gianlucarenzi/abex-megaram/(list of files, drawings)

Other design files:
abex-megaram.dsn
