gianlucarenzi/abex-megaram/abex-megaram.kicad_pcb

## KiCad design abex-megaram.kicad_pcb (2019-07-20)

Schematic: abex-megaram.sch, ATARI XE 1 MegaRAM Expansion DEBUG/Logic

Parts:
C1: 100n; C_1206_HandSoldering
FT232RPi.1: CONN_01X03; Pin_Header_Straight_1x03
JP1: CONN_01X02; Pin_Header_Straight_1x02
JP2: CONN_01X04; Pin_Header_Angled_1x04
P1: 0877159106; BUS_PCIexpress_64pin
P2, P3, P4, P5: CONN_01X01; MountingHole
R1: 100K; R_1206_HandSoldering
R2: 0; R_1206_HandSoldering
SW1: SW_Push; SW_SPST_FSMSM_3D

Connections:
GND: C1.1, FT232RPi.1.1, JP1.2, JP2.1, P1.A1, P1.A5, P1.A9, P1.A13, P1.A17, P1.A21, P1.A25, P1.A29, P1.A32, P1.B17, P1.B21, P1.B25, R2.2, SW1.1; also elsewhere on the board
SWDCLK: JP2.3, P1.B29; also elsewhere on the board
SWDIO: JP2.2, P1.B27; also elsewhere on the board
SWDRST: C1.2, JP1.1, P1.B31, R1.1, SW1.2; also elsewhere on the board
UART_RX: FT232RPi.1.2; also elsewhere on the board
UART_TX: FT232RPi.1.3; also elsewhere on the board
VCC_3V3: JP2.4, P1.A3, P1.A7, P1.A11, P1.A15, P1.A19, P1.A23, P1.A27, P1.B19, P1.B23, R1.2; also elsewhere on the board
mA0: P1.B32; also elsewhere on the board
mA1: P1.B30; also elsewhere on the board
mA2: P1.B28; also elsewhere on the board
mA3: P1.B26; also elsewhere on the board
mA4: P1.B24; also elsewhere on the board
mA5: P1.B22; also elsewhere on the board
mA6: P1.B20; also elsewhere on the board
mA7: P1.B18; also elsewhere on the board
mA8: P1.B16; also elsewhere on the board
mA9: P1.B14; also elsewhere on the board
mA10: P1.B12; also elsewhere on the board
mA11: P1.B10; also elsewhere on the board
mA12: P1.B8; also elsewhere on the board
mA13: P1.B6; also elsewhere on the board
mA14: P1.B4; also elsewhere on the board
mA15: P1.B2; also elsewhere on the board
mAUDIO: P1.A6, R2.1
mD0: P1.B15; also elsewhere on the board
mD1: P1.B13; also elsewhere on the board
mD2: P1.B11; also elsewhere on the board
mD3: P1.B9; also elsewhere on the board
mD4: P1.B7; also elsewhere on the board
mD5: P1.B5; also elsewhere on the board
mD6: P1.B3; also elsewhere on the board
mD7: P1.B1; also elsewhere on the board
mPHI2: P1.A4; also elsewhere on the board
mR/~W: P1.A10; also elsewhere on the board
mRD4: P1.A24; also elsewhere on the board
mRD5: P1.A28; also elsewhere on the board
~mCCTL: P1.A30; also elsewhere on the board
~mD1XX: P1.A18; also elsewhere on the board
~mEXSEL: P1.A12; also elsewhere on the board
~mHALT: P1.A16; also elsewhere on the board
~mIRQ: P1.A14; also elsewhere on the board
~mMPD: P1.A20; also elsewhere on the board
~mREF: P1.A8; also elsewhere on the board
~mRST: P1.A2; also elsewhere on the board
~mS4: P1.A22; also elsewhere on the board
~mS5: P1.A26; also elsewhere on the board

Notes on the sheet:
DEBUG/PROGRAMMING SECTION MEMORY
MOUNTING HOLES
RESET BUTTON MEM
EXTENDED BUS PINS ARE CONNECTED IN THE SLOT BUT LEFT UNTRACKED
DNP
ABEX PCI EXPRESS CARD CONNECTOR 64 PIN
A31 is +5VDC. We do not need here

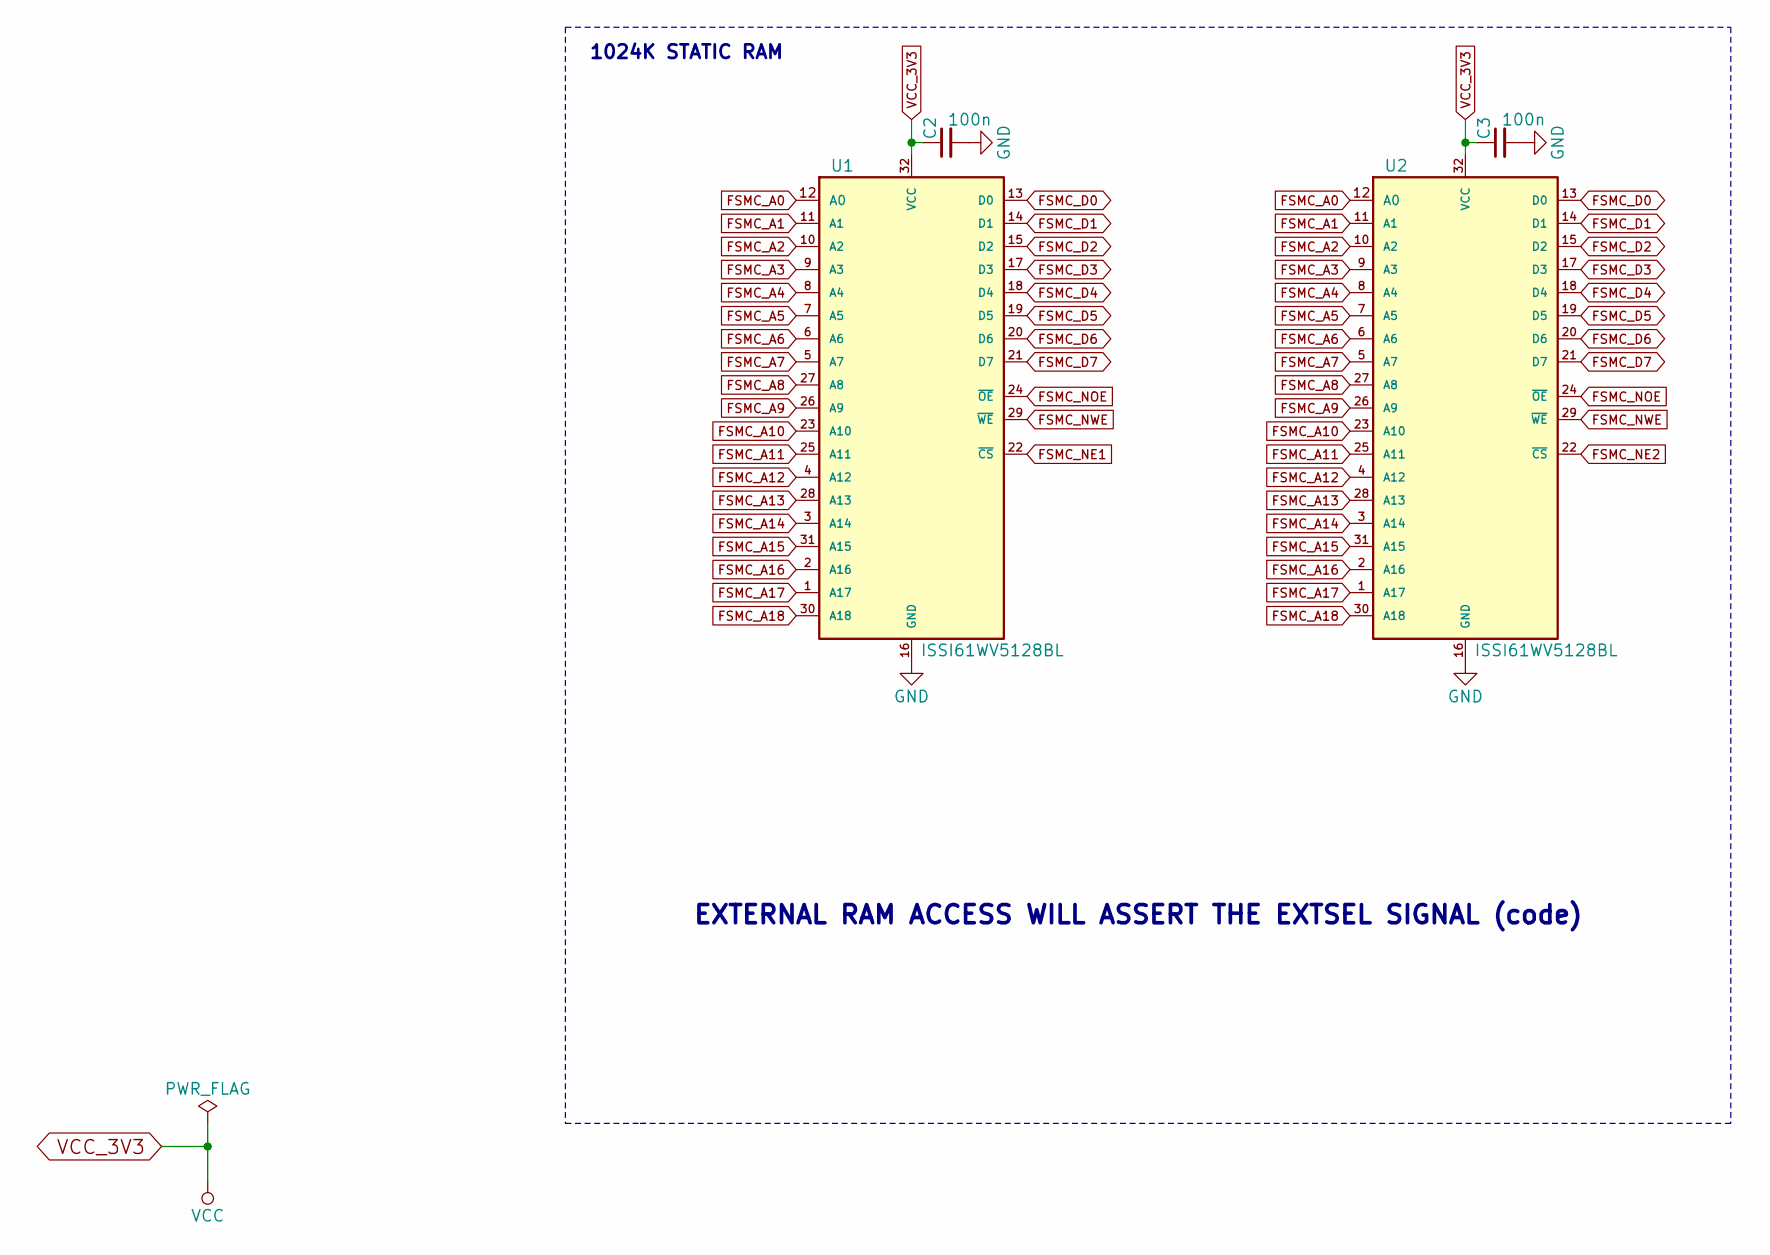
[picture p7: schematic sram-levelshifters.sch, STATIC RAM 1 MByte (512K x 8 x 2)]

Parts:
C2, C3: 100n; C_1206_HandSoldering
U1, U2: ISSI61WV5128BL; SOP-32L-20.5x11.30-1.27mm

Connections:
FSMC_A0: U1.12 (A0), U2.12 (A0); also elsewhere on the board
FSMC_A1: U1.11 (A1), U2.11 (A1); also elsewhere on the board
FSMC_A2: U1.10 (A2), U2.10 (A2); also elsewhere on the board
FSMC_A3: U1.9 (A3), U2.9 (A3); also elsewhere on the board
FSMC_A4: U1.8 (A4), U2.8 (A4); also elsewhere on the board
FSMC_A5: U1.7 (A5), U2.7 (A5); also elsewhere on the board
FSMC_A6: U1.6 (A6), U2.6 (A6); also elsewhere on the board
FSMC_A7: U1.5 (A7), U2.5 (A7); also elsewhere on the board
FSMC_A8: U1.27 (A8), U2.27 (A8); also elsewhere on the board
FSMC_A9: U1.26 (A9), U2.26 (A9); also elsewhere on the board
FSMC_A10: U1.23 (A10), U2.23 (A10); also elsewhere on the board
FSMC_A11: U1.25 (A11), U2.25 (A11); also elsewhere on the board
FSMC_A12: U1.4 (A12), U2.4 (A12); also elsewhere on the board
FSMC_A13: U1.28 (A13), U2.28 (A13); also elsewhere on the board
FSMC_A14: U1.3 (A14), U2.3 (A14); also elsewhere on the board
FSMC_A15: U1.31 (A15), U2.31 (A15); also elsewhere on the board
FSMC_A16: U1.2 (A16), U2.2 (A16); also elsewhere on the board
FSMC_A17: U1.1 (A17), U2.1 (A17); also elsewhere on the board
FSMC_A18: U1.30 (A18), U2.30 (A18); also elsewhere on the board
FSMC_D0: U1.13 (D0), U2.13 (D0); also elsewhere on the board
FSMC_D1: U1.14 (D1), U2.14 (D1); also elsewhere on the board
FSMC_D2: U1.15 (D2), U2.15 (D2); also elsewhere on the board
FSMC_D3: U1.17 (D3), U2.17 (D3); also elsewhere on the board
FSMC_D4: U1.18 (D4), U2.18 (D4); also elsewhere on the board
FSMC_D5: U1.19 (D5), U2.19 (D5); also elsewhere on the board
FSMC_D6: U1.20 (D6), U2.20 (D6); also elsewhere on the board
FSMC_D7: U1.21 (D7), U2.21 (D7); also elsewhere on the board
FSMC_NE1: U1.22 (~CS); also elsewhere on the board
FSMC_NE2: U2.22 (~CS); also elsewhere on the board
FSMC_NOE: U1.24 (~OE), U2.24 (~OE); also elsewhere on the board
FSMC_NWE: U1.29 (~WE), U2.29 (~WE); also elsewhere on the board
GND: C2.2, C3.2, U1.16 (GND), U2.16 (GND); also elsewhere on the board
VCC_3V3: C2.1, C3.1, U1.32 (VCC), U2.32 (VCC); also elsewhere on the board

Notes on the sheet:
1024K STATIC RAM
EXTERNAL RAM ACCESS WILL ASSERT THE EXTSEL SIGNAL (code)

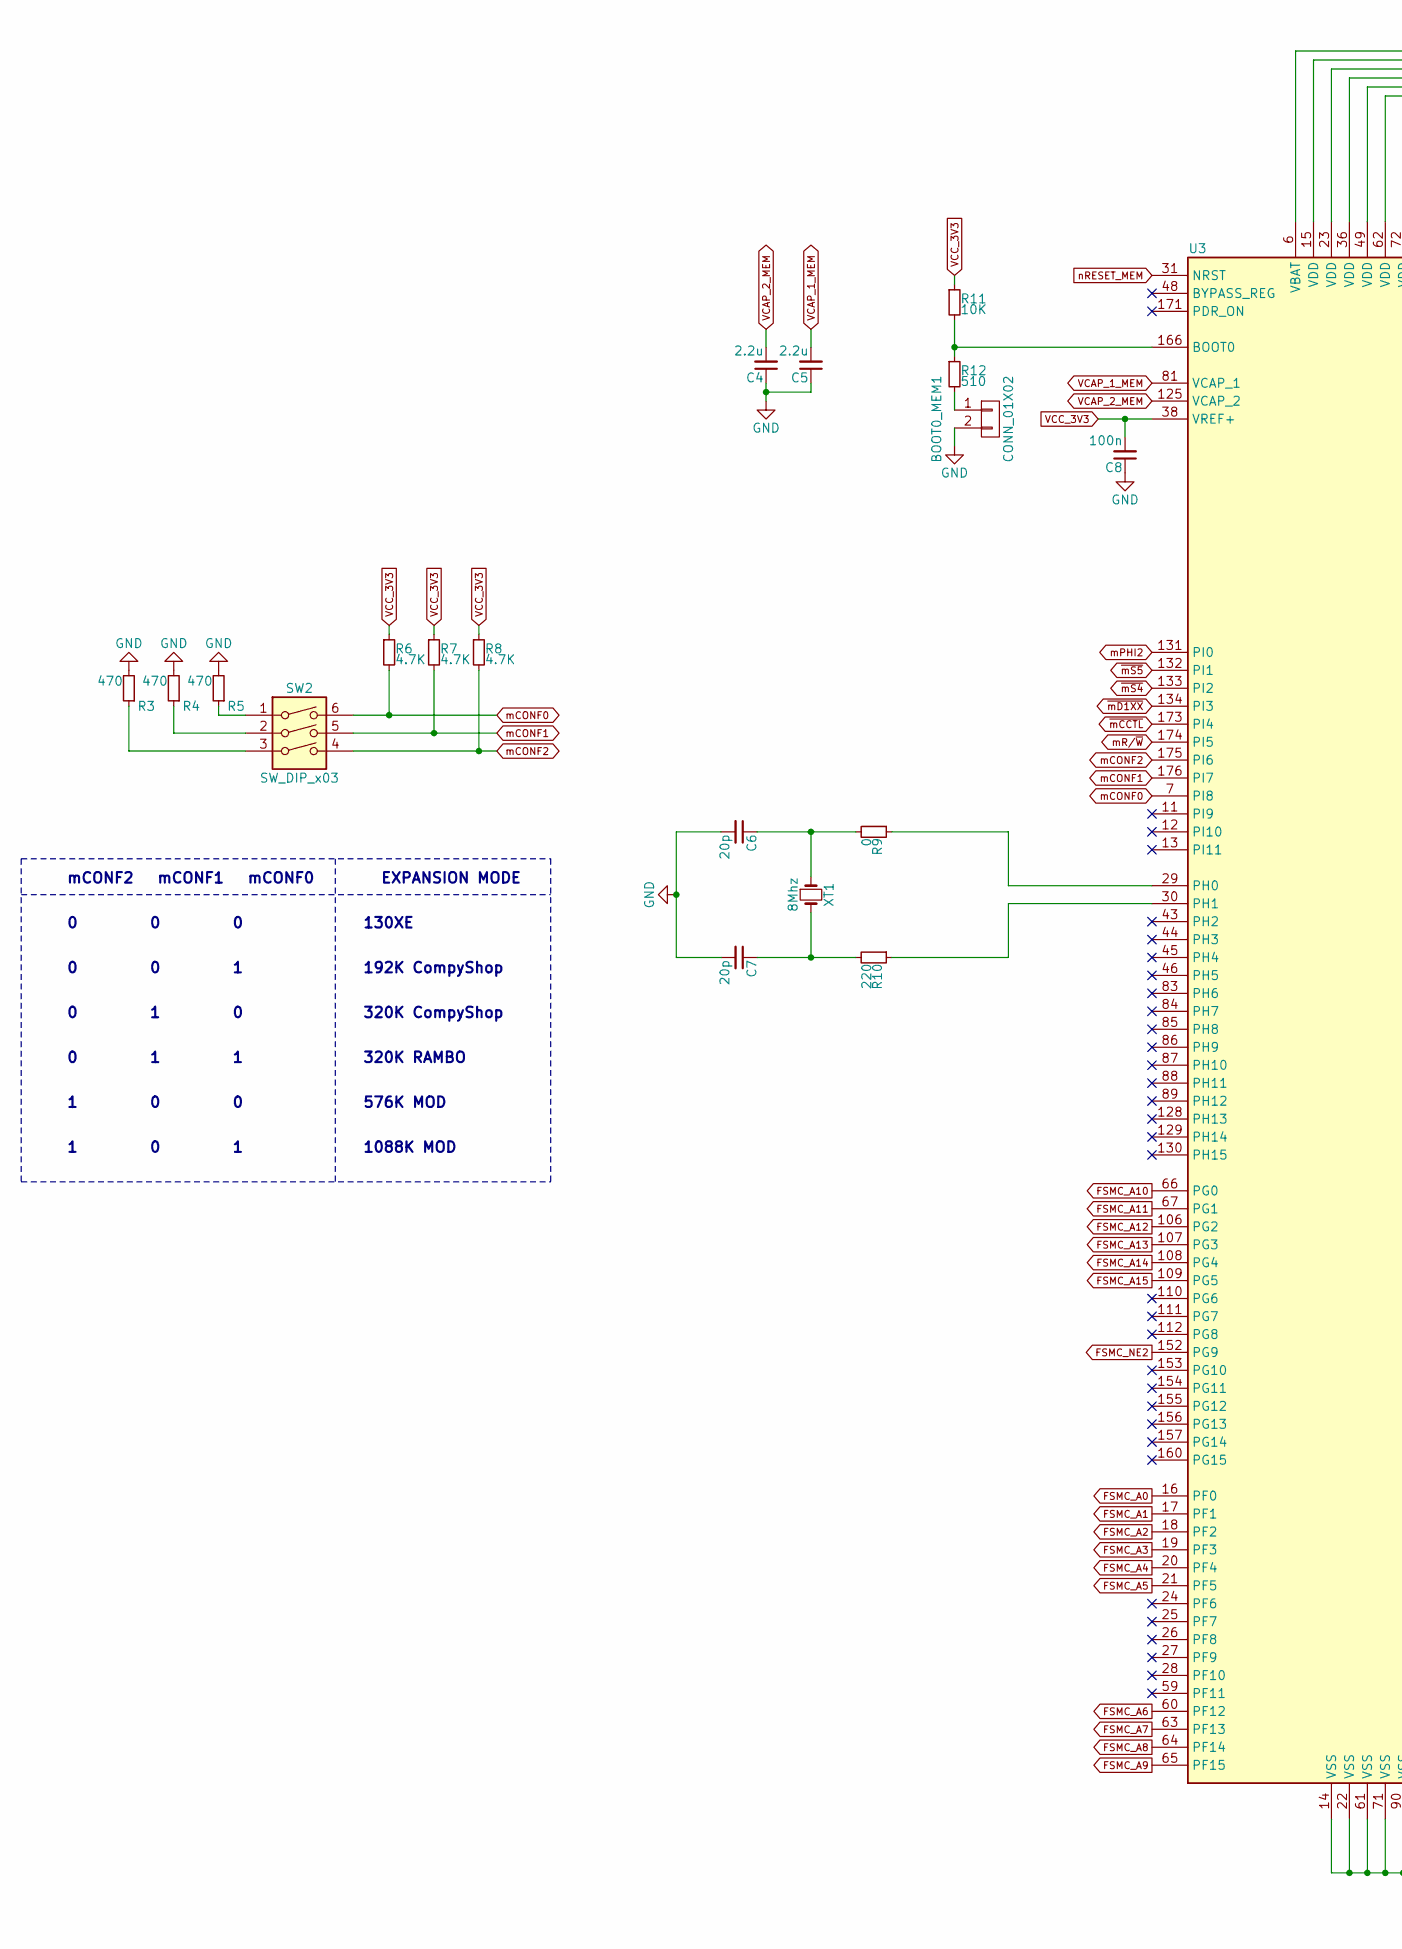
[picture p8: schematic memory_controller.sch, MCU STM32F407VET6 MEMORY CONTROLLER, part in row 1, column 1]

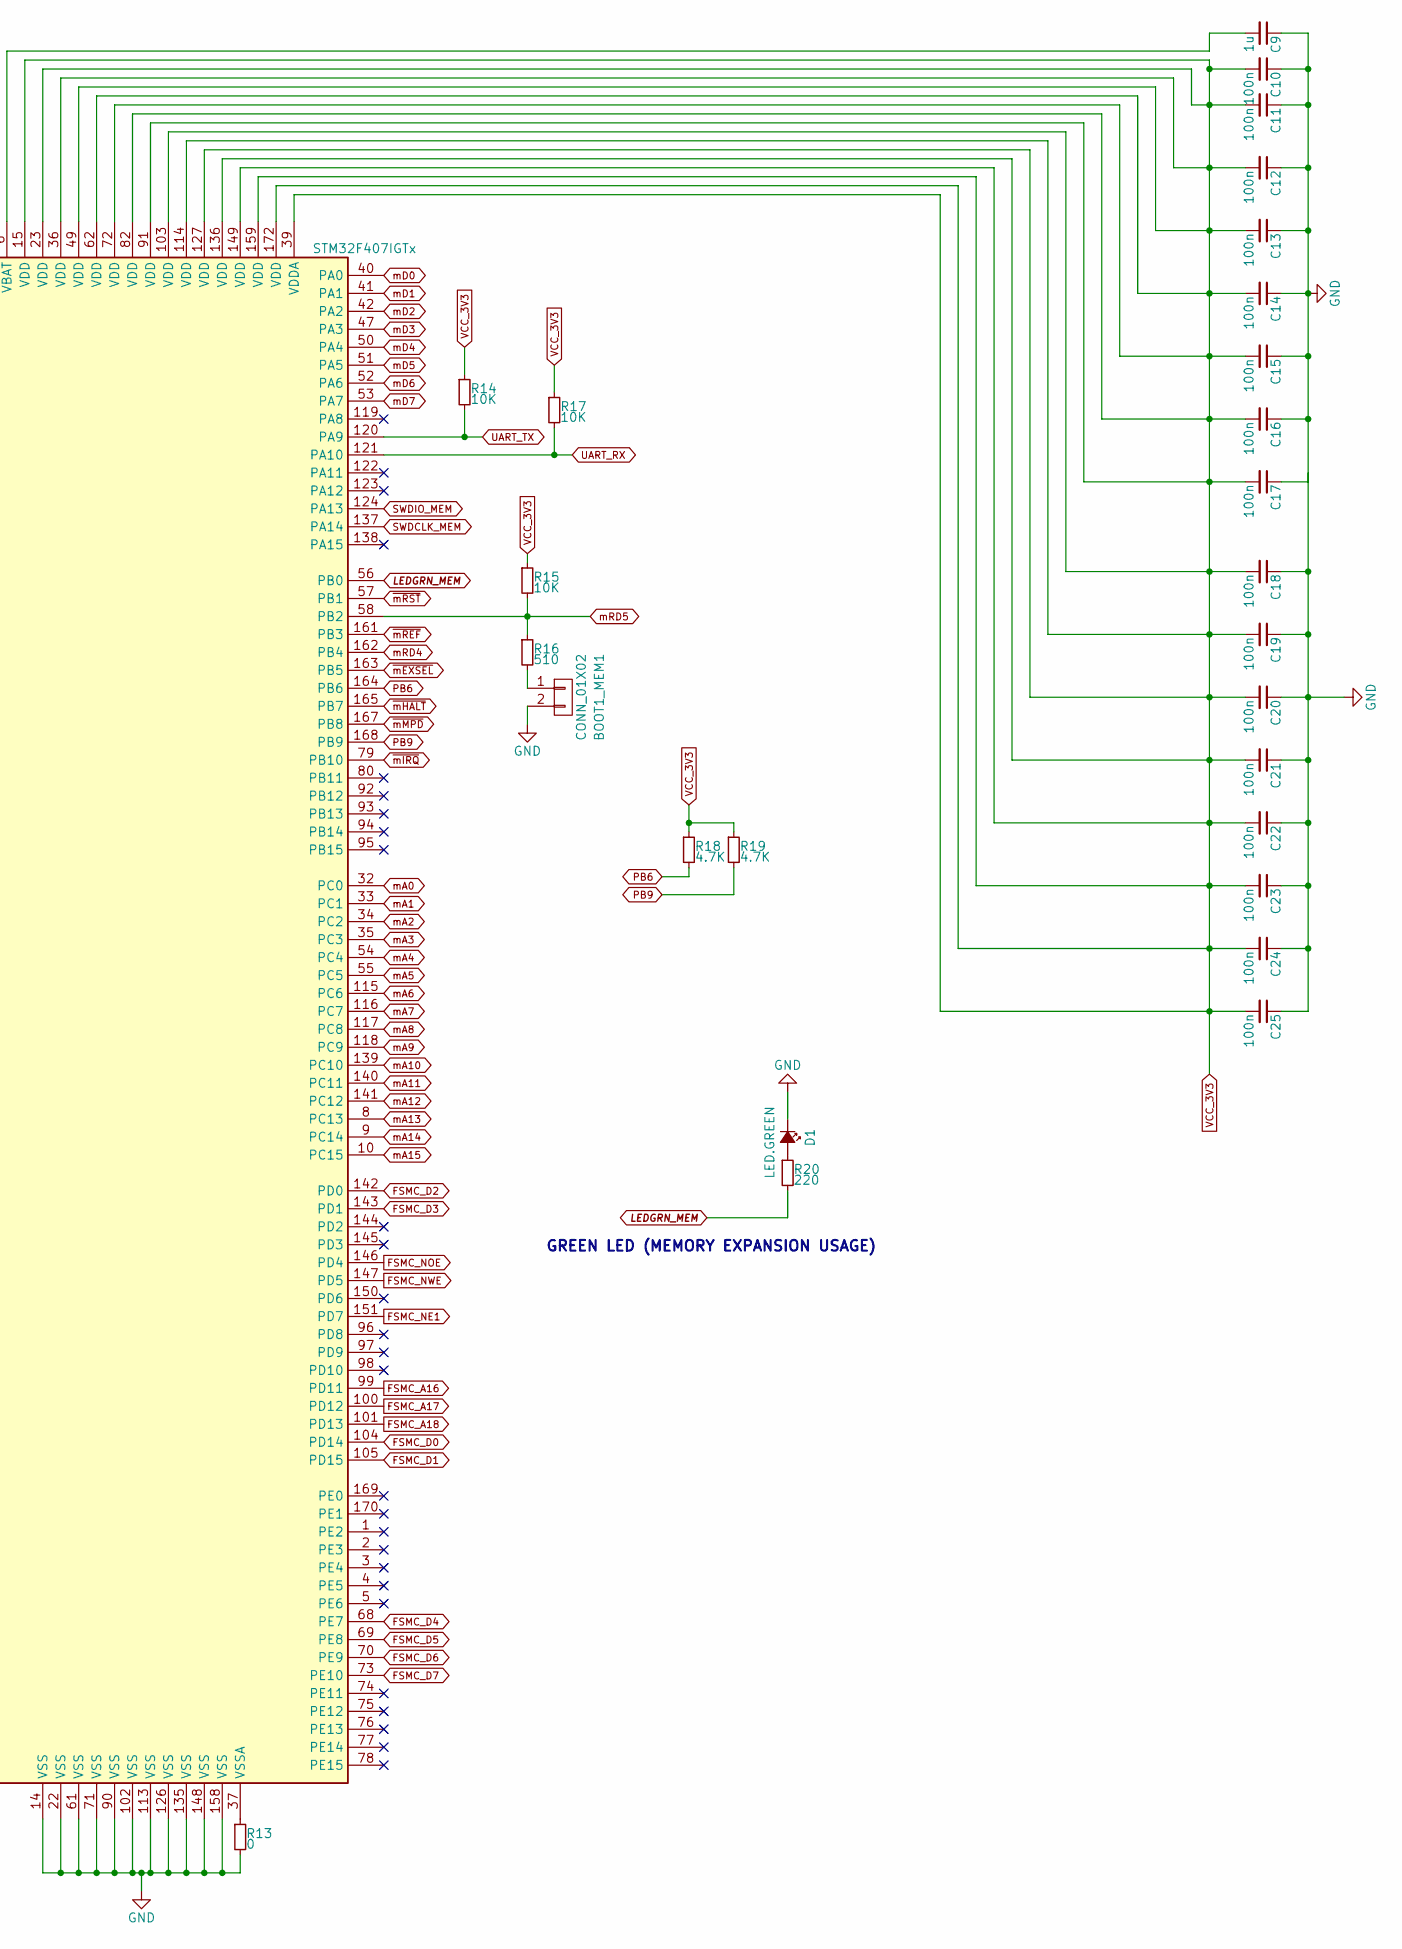
[picture p9: schematic memory_controller.sch, MCU STM32F407VET6 MEMORY CONTROLLER, part in row 1, column 2]

Parts:
BOOT0_MEM1, BOOT1_MEM1: CONN_01X02; Pin_Header_Straight_1x02
C4, C5: 2.2u; C_1206_HandSoldering
C6, C7: 20p; C_1206_HandSoldering
C8, C10, C11, C12, C13, C14, C15, C16, C17, C18, C19, C20, C21, C22, C23, C24, C25: 100n; C_1206_HandSoldering
C9: 1u; C_1206_HandSoldering
D1: LED.GREEN; LED_1206
R3, R4, R5: 470; R_1206_HandSoldering
R6, R7, R8, R18, R19: 4.7K; R_1206_HandSoldering
R9, R13: 0; R_1206_HandSoldering
R10, R20: 220; R_1206_HandSoldering
R11, R14, R15, R17: 10K; R_1206_HandSoldering
R12, R16: 510; R_1206_HandSoldering
SW2: SW_DIP_x03; SW_DIP_SPSTx03_Slide_9.78x9.8mm_W8.61mm_P2.54mm
U3: STM32F407IGTx; LQFP-176_24x24mm_Pitch0.5mm
XT1: 8Mhz; Crystal_HC49-4H_Vertical_3D

Connections:
FSMC_A0: U3.16 (PF0); also elsewhere on the board
FSMC_A1: U3.17 (PF1); also elsewhere on the board
FSMC_A2: U3.18 (PF2); also elsewhere on the board
FSMC_A3: U3.19 (PF3); also elsewhere on the board
FSMC_A4: U3.20 (PF4); also elsewhere on the board
FSMC_A5: U3.21 (PF5); also elsewhere on the board
FSMC_A6: U3.60 (PF12); also elsewhere on the board
FSMC_A7: U3.63 (PF13); also elsewhere on the board
FSMC_A8: U3.64 (PF14); also elsewhere on the board
FSMC_A9: U3.65 (PF15); also elsewhere on the board
FSMC_A10: U3.66 (PG0); also elsewhere on the board
FSMC_A11: U3.67 (PG1); also elsewhere on the board
FSMC_A12: U3.106 (PG2); also elsewhere on the board
FSMC_A13: U3.107 (PG3); also elsewhere on the board
FSMC_A14: U3.108 (PG4); also elsewhere on the board
FSMC_A15: U3.109 (PG5); also elsewhere on the board
FSMC_A16: U3.99 (PD11); also elsewhere on the board
FSMC_A17: U3.100 (PD12); also elsewhere on the board
FSMC_A18: U3.101 (PD13); also elsewhere on the board
FSMC_D0: U3.104 (PD14); also elsewhere on the board
FSMC_D1: U3.105 (PD15); also elsewhere on the board
FSMC_D2: U3.142 (PD0); also elsewhere on the board
FSMC_D3: U3.143 (PD1); also elsewhere on the board
FSMC_D4: U3.68 (PE7); also elsewhere on the board
FSMC_D5: U3.69 (PE8); also elsewhere on the board
FSMC_D6: U3.70 (PE9); also elsewhere on the board
FSMC_D7: U3.73 (PE10); also elsewhere on the board
FSMC_NE1: U3.151 (PD7); also elsewhere on the board
FSMC_NE2: U3.152 (PG9); also elsewhere on the board
FSMC_NOE: U3.146 (PD4); also elsewhere on the board
FSMC_NWE: U3.147 (PD5); also elsewhere on the board
GND: BOOT0_MEM1.2, BOOT1_MEM1.2, C4.1, C5.1, C6.2, C7.2, C8.1, C9.1, C10.1, C11.1, C12.1, C13.1, C14.1, C15.1, C16.1, C17.1, C18.1, C19.1, C20.1, C21.1, C22.1, C23.1, C24.1, C25.1, D1.1 (K), R3.2, R4.2, R5.2, R13.2, U3.14 (VSS), U3.22 (VSS), U3.61 (VSS), U3.71 (VSS), U3.90 (VSS), U3.102 (VSS), U3.113 (VSS), U3.126 (VSS), U3.135 (VSS), U3.148 (VSS), U3.158 (VSS); also elsewhere on the board
LEDGRN_MEM: R20.2, U3.56 (PB0)
unnamed: BOOT0_MEM1.1, R12.2
unnamed: BOOT1_MEM1.1, R16.2
unnamed: C6.1, R9.2, XT1.1
unnamed: C7.1, R10.2, XT1.2
unnamed: C9.2, U3.6 (VBAT)
unnamed: D1.2 (A), R20.1
unnamed: R3.1, SW2.3
unnamed: R4.1, SW2.2
unnamed: R5.1, SW2.1
unnamed: R9.1, U3.29 (PH0)
unnamed: R10.1, U3.30 (PH1)
unnamed: R11.2, R12.1, U3.166 (BOOT0)
unnamed: R13.1, U3.37 (VSSA)
PB6: R18.2, U3.164 (PB6)
PB9: R19.2, U3.168 (PB9)
SWDCLK: U3.137 (PA14); also elsewhere on the board
SWDIO: U3.124 (PA13); also elsewhere on the board
SWDRST: U3.31 (NRST); also elsewhere on the board
UART_RX: R17.2, U3.121 (PA10); also elsewhere on the board
UART_TX: R14.2, U3.120 (PA9); also elsewhere on the board
VCAP_1_MEM: C5.2, U3.81 (VCAP_1)
VCAP_2_MEM: C4.2, U3.125 (VCAP_2)
VCC_3V3: C8.2, C10.2, C11.2, C12.2, C13.2, C14.2, C15.2, C16.2, C17.2, C18.2, C19.2, C20.2, C21.2, C22.2, C23.2, C24.2, C25.2, R6.1, R7.1, R8.1, R11.1, R14.1, R15.1, R17.1, R18.1, R19.1, U3.15 (VDD), U3.23 (VDD), U3.36 (VDD), U3.38 (VREF+), U3.39 (VDDA), U3.49 (VDD), U3.62 (VDD), U3.72 (VDD), U3.82 (VDD), U3.91 (VDD), U3.103 (VDD), U3.114 (VDD), U3.127 (VDD), U3.136 (VDD), U3.149 (VDD), U3.159 (VDD), U3.172 (VDD); also elsewhere on the board
mA0: U3.32 (PC0); also elsewhere on the board
mA1: U3.33 (PC1); also elsewhere on the board
mA2: U3.34 (PC2); also elsewhere on the board
mA3: U3.35 (PC3); also elsewhere on the board
mA4: U3.54 (PC4); also elsewhere on the board
mA5: U3.55 (PC5); also elsewhere on the board
mA6: U3.115 (PC6); also elsewhere on the board
mA7: U3.116 (PC7); also elsewhere on the board
mA8: U3.117 (PC8); also elsewhere on the board
mA9: U3.118 (PC9); also elsewhere on the board
mA10: U3.139 (PC10); also elsewhere on the board
mA11: U3.140 (PC11); also elsewhere on the board
mA12: U3.141 (PC12); also elsewhere on the board
mA13: U3.8 (PC13); also elsewhere on the board
mA14: U3.9 (PC14); also elsewhere on the board
mA15: U3.10 (PC15); also elsewhere on the board
mCONF0: R6.2, SW2.6, U3.7 (PI8)
mCONF1: R7.2, SW2.5, U3.176 (PI7)
mCONF2: R8.2, SW2.4, U3.175 (PI6)
mD0: U3.40 (PA0); also elsewhere on the board
mD1: U3.41 (PA1); also elsewhere on the board
mD2: U3.42 (PA2); also elsewhere on the board
mD3: U3.47 (PA3); also elsewhere on the board
mD4: U3.50 (PA4); also elsewhere on the board
mD5: U3.51 (PA5); also elsewhere on the board
mD6: U3.52 (PA6); also elsewhere on the board
mD7: U3.53 (PA7); also elsewhere on the board
mPHI2: U3.131 (PI0); also elsewhere on the board
mR/~W: U3.174 (PI5); also elsewhere on the board
mRD4: U3.162 (PB4); also elsewhere on the board
mRD5: R15.2, R16.1, U3.58 (PB2); also elsewhere on the board
~mCCTL: U3.173 (PI4); also elsewhere on the board
~mD1XX: U3.134 (PI3); also elsewhere on the board
~mEXSEL: U3.163 (PB5); also elsewhere on the board
~mHALT: U3.165 (PB7); also elsewhere on the board
~mIRQ: U3.79 (PB10); also elsewhere on the board
~mMPD: U3.167 (PB8); also elsewhere on the board
~mREF: U3.161 (PB3); also elsewhere on the board
~mRST: U3.57 (PB1); also elsewhere on the board
~mS4: U3.133 (PI2); also elsewhere on the board
~mS5: U3.132 (PI1); also elsewhere on the board

Notes on the sheet:
GREEN LED (MEMORY EXPANSION USAGE)
mCONF2 mCONF1 mCONF0
0 0 0
0 0 1
0 1 0
0 1 1
1 0 1
130XE
192K CompyShop
320K CompyShop
320K RAMBO
1088K MOD
EXPANSION MODE
1 0 0
576K MOD

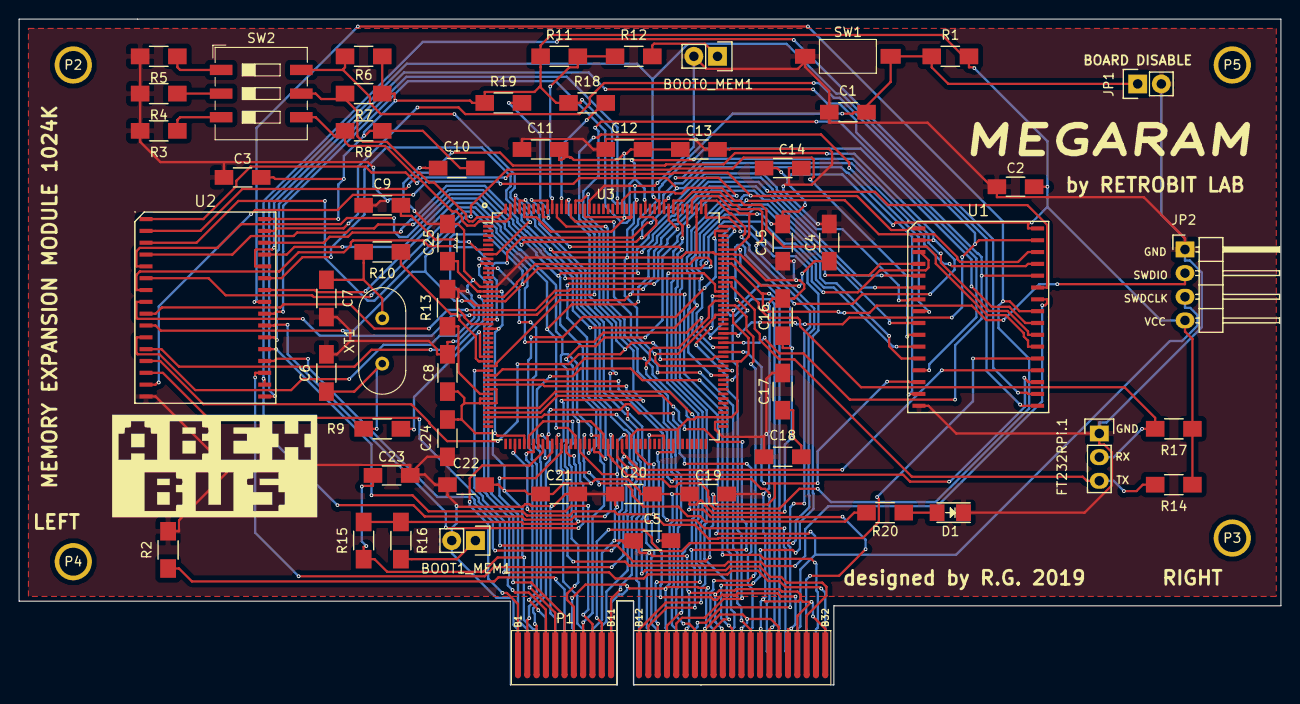
[picture p10: board abex-megaram.kicad_pcb from above]

Board: 2 copper layers, 135.5 x 71.5 mm, 62 parts (0 on the bottom side), 98 nets.
