gianlucarenzi/abex-megaram/(commit log)

2019-05-25 Frist Commit
    [abex-megaram-B.Cu.gbl, abex-megaram-B.Mask.gbs, abex-megaram-B.Paste.gbp, abex-megaram-B.SilkS.gbo, abex-megaram-Edge.Cuts.gm1, abex-megaram-F.Cu.gtl, abex-megaram-F.Mask.gts, abex-megaram-F.Paste.gtp]
2019-06-02 Added a three channel dip-switch for select configuration
    [abex-megaram-B.Cu.gbl, abex-megaram-B.Mask.gbs, abex-megaram-B.Paste.gbp, abex-megaram-B.SilkS.gbo, abex-megaram-Edge.Cuts.gm1, abex-megaram-F.Cu.gtl, abex-megaram-F.Mask.gts, abex-megaram-F.Paste.gtp]
2019-06-04 Aggiunto .gitignore per il risultato di compilazione
2019-06-27 Added for STM32 flash programming via OpenOCD
    [stm32f4eval.cfg]
2019-06-27 Added configuration pin (dip-switches) The data bus is now connected to the lower bits of the portE, so no need for shifting when read/write to the ATARI MCU DataBus. It will improve the efficiency
2019-06-27 Optimized for 8 bit access. Added a configuration option. A31 on connector is 5VDC. Not used here
    [abex-megaram-B.Cu.gbl, abex-megaram-B.Mask.gbs, abex-megaram-B.Paste.gbp, abex-megaram-B.SilkS.gbo, abex-megaram-Edge.Cuts.gm1, abex-megaram-F.Cu.gtl, abex-megaram-F.Mask.gts, abex-megaram-F.Paste.gtp]
2019-07-19 Upgraded to a dual chip select for external SRAM. In this case up to 1536k can be addressable
    [abex-megaram-B.Cu.gbl, abex-megaram-B.Mask.gbs, abex-megaram-B.Paste.gbp, abex-megaram-B.SilkS.gbo, abex-megaram-Edge.Cuts.gm1, abex-megaram-F.Cu.gtl, abex-megaram-F.Mask.gts, abex-megaram-F.Paste.gtp]
2019-07-19 Added nOE and nWE from the GPIOs
    [abex-megaram.dsn, abex-megaram.kicad_pcb, memory_controller.sch, sram-levelshifters.sch]
2019-07-20 New layout and design
    [abex-megaram-B.Cu.gbl, abex-megaram-B.Mask.gbs, abex-megaram-B.Paste.gbp, abex-megaram-B.SilkS.gbo, abex-megaram-Edge.Cuts.gm1, abex-megaram-F.Cu.gtl, abex-megaram-F.Mask.gts, abex-megaram-F.Paste.gtp]
2019-07-24 Corrected comment. Added the control of the PBCTL & (1 << 2) to write internally to PORTB as asked by Warerat of AtariAge's Forum
    [main.c]
2019-07-25 Added for SoC Programming and Controlling
    [stm32f4eval.cfg]
2019-07-25 - Heavily modified as the control bit as atari800 emulator and the RAMBO 256K Expansion Reference Manual - Added the possibility to program the compatibility mode from atari. Simply write 255 times t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
    [main.c]
2019-07-26 Added printf support
2025-11-01 RetroBitLab library
    [abex-megaram.sch, expansionslotspt.sch, memory_controller.sch, sram-levelshifters.sch]
2026-06-29 Fix 5 bugs in bus controller: FMC write, GPIO MODER, DIP mapping, 1088K RAM size, dead code
    - Enable FMC write operation (was DISABLE: all writes to external SRAM silently dropped)
    - SET_DATA_MODE_IN/OUT now masks upper 16 bits to preserve PA9/PA10 USART1 AF mode
    - Fix DIP switch comment: enum mapping was wrong by 2 positions (1088K was showing as 576K)
    - RAMSIZ increased to 64*0x4000 to cover all 1088K banks; remove bank==63 aliasing hack
    - Remove unused t_command enum and PHI2_RD/S4_RD/S5_RD/D1XX_RD/S4_AND_S5_HIGH macros
    [main.c]
2026-06-29 Ottimizzazione I/O, loop di sniffing, overclock a 216MHz e fix linker script per SRAM
    [main.c]
2026-06-29 Fix FMC timing: DataSetupTime 255->2 cycles for AS7C38096A-10TIN at 180MHz
    Previous values (ADDSET=15, DATAST=255) gave ~1260ns read latency, far exceeding
    the ~280ns Atari PHI2 window. AS7C38096A-10TIN needs tAA=10ns; at 180MHz HCLK
    (5.55ns/cycle) DATAST=2 gives 16.7ns which satisfies tAA with margin.
    [main.c]
2026-06-29 Revert CPU clock to 180MHz: STM32F429 datasheet max is 180MHz
    216MHz with FLASH_LATENCY_7 was out-of-spec for STM32F429IGTx (DS8080).
    Restore PLL multiplier to 180, LATENCY_5 (correct for 180MHz at 3.3V),
    and all associated tick/sysclk values.
    [main.c]
2026-06-29 Add missing EXPANSION_TYPE_576K_COMPYSHOP case in banner()
    Was falling through to default 'UNKNOWN EXPANSION TYPE!' despite being
    a valid and handled expansion type.
    [main.c]
2026-06-29 Optimize hot path: CCMRAM bank LUT + eliminate redundant GPIOI read
    - Replace switch(EMULATION_TYPE) + multi-step bit arithmetic with a
    256-byte precomputed bank_lut[PORTB] in CCMRAM (zero wait states on
    Cortex-M4 core): bank lookup collapses to a single load, saving ~7
    cycles per banked RAM access.
    - Capture control signals (c) directly in the PHI2 poll condition,
    eliminating one redundant peripheral read per bus cycle (~3 cycles).
    - init_bank_lut() called at startup and on runtime type change (D1FE).
    - internal_address now uses shift (bank<<14) instead of multiply.
    - Total hot-path saving: ~10 cycles; margin vs PHI2 window grows from
    ~3-6 to ~13-16 cycles (72-89ns at 180MHz).
    [main.c]
2026-06-29 fix(bank_lut): CBE-only for 130XE/192K; RAME=1 disables 256K_RAMBO; fix CONF comment
    - EXPANSION_TYPE_130XE/192K: use !(p & 0x10) instead of (p & 0x30) != 0x30;
    VBE (bit 5) is ANTIC-only and never visible on PHI2 cycles
    - EXPANSION_TYPE_256K_RAMBO: RAME=1 returns 0xFF (Atari internal RAM responds),
    not bk & 0x3; aligns with RAMBO manual and 320K behaviour
    - MEMORY_EXPANSION_TYPE comment: PI6/PI7/PI8 = CONF0/CONF1/CONF2
    [main.c]
2026-06-29 fix(ld): mark .ccmram as NOLOAD — startup never copies it from FLASH
    bank_lut is always runtime-initialised by init_bank_lut(); AT> FLASH
    was silently wasting 256 bytes of FLASH image with zeros.
2026-06-29 feat(hw): add FPGA/CPLD Verilog implementation of ATARI memory expansion
    Fully open-source toolchain (Yosys + nextpnr iCE40/ECP5).
    Mirrors all 8 expansion types from init_bank_lut() in src/main.c.
    hw/rtl/bank_switch.v — combinational bank decoder (all 8 types)
    hw/rtl/portb_emu.v — PORTB/PBCTL/DDRB register file (negedge PHI2)
    hw/rtl/top.v — top: address decode, SRAM ctrl, data-bus mux
    hw/sim/tb_top.v — Icarus Verilog testbench (6 test cases)
    hw/constraints/ice40hx8k.pcf — iCE40HX-8K pin template
    hw/constraints/ecp5_25k.lpf — ECP5-25k pin template
    hw/Makefile — targets: ice40, ecp5, sim, prog_ice40
    hw/README.md — toolch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
2026-06-29 fix(hw/rtl): latch write data on posedge PHI2 to break combinational loop
    atari_data → sram_data → atari_out → atari_data was a structural
    combinational loop caused by bidirectional inout coupling.
    Registering write_latch on posedge PHI2 breaks the loop (6502 guarantees
    write data valid before PHI2 rises) and improves SRAM write timing margin.
    Yosys warnings reduced from 10 to 2 (expected IO-pad tribuf warnings).
    Synthesises to 68× SB_LUT4 + 24× SB_DFFNE + 8× SB_DFF on iCE40.
    [top.v]
2026-06-29 hw: redesign RTL per topologia B (SRAM direttamente sul bus Atari)
    La SRAM non e' piu' collegata alla FPGA come bridge dati: il bus dati
    della SRAM viene cablato direttamente al bus Atari via level-shifter
    bidirezionali sul PCB (TXS0108B, clone TXS0108E), come nelle espansioni
    reali (RAMBO, Compyshop).
    La FPGA diventa pura glue logic:
    - top.v: rimossi sram_data (inout), write_latch e il mux dati;
    atari_data e' guidato solo per le letture PIA ($D301/$D303)
    - constraints/ice40hx8k.pcf: rimossi i pin sram_data[7:0]
    - constraints/ecp5_25k.lpf: rimossi i pin sram_data[7:0]
    - sim/tb_top.v: il modello SRAM guida/riceve da atari_data (bus condiviso);
    test T3 campiona i segnali di controllo a m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
    [ice40hx8k.pcf, tb_top.v, top.v]
2026-06-29 port(fw): migrazione firmware da STM32F429 a STM32H5E5ZJ (Cortex-M33, 250 MHz)
    - Rimozione FMC: expansion_ram[1 MB] in SRAM interna (sezione .sram NOLOAD)
    - Clock: HSE 8 MHz, PLL1 M=2/N=125/P=2 → 250 MHz, VOS0
    - GPIO su AHB2 (era AHB1 su F4); aggiunto PCLK3
    - Linker: Flash 4 MB, RAM 256 K + SRAM_EXP 1280 K (totale 1536 K)
    - Pin TODO in inc/main.h: aggiornare con schematico PCB H5E5ZJ
    - Aggiunta BSP STM32H5xx_HAL_Driver e CMSIS Device H5xx
    - Startup: startup_stm32h5e5xx.s, system_stm32h5xx.c
    - Build verificata: 17 KB text, 0 errori
    [main.c, main.h, syscall.c, syscall.h]
